win-good/SmartCar_RTOS/README.md

# SmartCar_RTOS
基于 FreeRTOS 搭建传感、决策、电机、蓝牙、视觉、雷达、显示 7 个并行线程任务，消息队列协同调度，实现 10ms 级电机控制与 20ms 级感知决策，配置看门狗与 I2C 总线自救。
