win-good/SmartCar_RTOS/搭建过程总结资料/智能小车项目搭建问题难点与排查思路总结.docx

多模态智能小车

项目搭建过程问题、难点与排查思路总结

硬件平台：STM32F407VGT6 + K230 视觉 + LD2450 毫米波雷达 + FreeRTOS

编制日期：2026 年 9 月 5 日

# 1. 项目概况与系统构成

本项目以 STM32F407VGT6 为主控，构建了一套融合视觉识别、毫米波雷达、超声波测距、惯性导航与气体检测的多模态分级预警小车。系统运行 FreeRTOS 实时操作系统，通过多任务分工实现传感采集、决策融合、电机执行、人机交互与无线通信的并行处理。

## 1.1 硬件构成

类别 | 器件 | 作用
主控 | STM32F407VGT6 | 系统调度与决策核心，运行 FreeRTOS
视觉 | K230（YOLOv11n） | 行人、车辆目标检测，UART 下发识别结果
雷达 | LD2450 毫米波 | 目标距离与方位角检测，独立 UART 解析
测距 | HC-SR04 超声波 ×4 | 前、后、左、右四向障碍探测
姿态 | MPU6050 | 航向角与加速度，用于航向修正
驱动 | TB6612FNG | 双通道电机驱动，PWM 调速与方向控制
执行 | 直流减速电机 ×4 | 两两并联接入 TB6612 两个通道
环境 | MQ-2、MQ-3、DHT11 | 可燃气体、酒精浓度与温湿度检测
交互 | OLED SSD1306 | 状态显示，I2C2 总线
通信 | JDY-31 蓝牙 | 模式切换与遥控指令
避障 | 红外对管 ×2 | 近距循迹与避障辅助

表 1 系统硬件构成

## 1.2 软件任务架构

系统划分为七个 FreeRTOS 任务：传感任务负责超声波轮询与模拟量采集；决策任务完成多源数据融合与三级预警判定；电机任务执行速度与转向控制；蓝牙任务解析遥控指令；K230 任务接收视觉结果；雷达任务解析毫米波帧；显示任务刷新 OLED 界面。各任务通过全局状态结构与队列交互。

多任务架构带来的主要难点在于资源竞争与时序耦合：传感任务的忙等会挤压电机任务的执行窗口，共享状态的并发访问需要保护，这一类问题在后文的排查中反复出现。

# 2. 贯穿全程的排查方法论

本项目累计定位并修复的问题超过二十项，涉及硬件、驱动、协议、逻辑、时序与电源六个层面。在反复试错之后，逐渐沉淀出一套相对稳定的排查思路，它比任何单个问题的具体解法都更有价值。

## 2.1 六条核心原则

1. 分层定位：先确认故障属于硬件层、驱动层、协议层、逻辑层、时序层还是电源层，不同层级的排查手段完全不同，混层排查会浪费大量时间。
2. 版本对照：维护已知可用的历史版本作为基准，用文件差异比对定位回归点。这是本项目效率最高的手段，多次直接锁定问题代码行。
3. 硬件优先怀疑：当软件逻辑经检查确认无误、执行器却无响应时，应优先怀疑供电、接线与器件本身，而不是继续在代码里找原因。
4. 读寄存器取证：直接读取定时器比较寄存器、复位标志寄存器等硬件状态，可以证明软件指令是否真正下发，从而把软件与硬件的责任划清。
5. 最小化改动：确认根因后只改必要部分，避免顺手重构引入新问题；诊断代码用完必须清除，防止污染生产版本。
6. 先查官方协议：外设通信异常时，第一步是核对官方数据手册的帧格式与电气特性，而不是猜测或参考网络上的二手示例代码。

## 2.2 常见误区

- 误区一：把偶发故障当作已解决。接触不良类问题往往在特定状态下暂时消失，未复现不等于已修复。
- 误区二：只看代码不看电气。程序逻辑完全正确但供电不足时，执行器依然不动。
- 误区三：一次改多处。多个修改同时上电，无法判断哪个有效、哪个引入了新问题。
- 误区四：忽略常态负载。加热丝、视觉模块这类持续耗电器件容易被漏算。

# 3. 问题与难点清单

下表汇总了项目搭建过程中遇到的主要问题，按发现与解决的先后顺序排列。后续章节对其中影响较大、排查过程较曲折的问题展开详细说明。

编号 | 问题现象 | 根本原因 | 所属层级 | 状态
01 | OLED 移植后不显示或乱码 | HAL I2C 配置与字库编码不匹配 | 驱动层 | 已解决
02 | 超声波右向与后向无数据 | Echo 引脚 5V 电平导致主控卡死 | 硬件电气 | 已解决
03 | 侧向修正后画大圈不回正 | 时间脉冲式修正被反复触发 | 逻辑层 | 已解决
04 | 蓝牙切换模式后车辆静止 | 供电不足导致电机无法启动 | 电源层 | 已解决
05 | 红外触发后原地打转数秒 | 修正逻辑未设置退出条件 | 逻辑层 | 已解决
06 | 电机嗡鸣但不转动 | 稳压模块负载能力不足 | 电源层 | 已解决
07 | OLED 残留启动横幅字符 | 未在新界面绘制前清屏 | 逻辑层 | 已解决
08 | 雷达数据显示始终为双横线 | 帧同步头识别错误 | 协议层 | 已解决
09 | 静止目标误触发二级预警 | 未按速度字段过滤静止反射体 | 逻辑层 | 已解决
10 | 屏幕周期性闪烁与卡顿 | 自检函数每帧重复初始化屏幕 | 时序层 | 已解决
11 | 系统运行一段时间后冻结 | 栈溢出钩子进入死循环 | RTOS 配置 | 已解决
12 | 电机刷新被延迟 | 传感任务忙等挤压同级任务 | 时序层 | 已解决
13 | MPU6050 断开后车辆不前进 | 航向修正未写入基础速度 | 逻辑层 | 已解决
14 | 转向朝障碍侧偏移 | 无效测距值被当作最大距离 | 逻辑层 | 已解决

表 2 问题清单（高亮为本轮排查中影响最大的两项）

# 4. 重点问题排查过程详解

## 4.1 电机嗡鸣但不转动（电源层）

现象：切换任意模式，四个电机均发出微弱嗡鸣声但不转动；软件检查显示 PWM 与方向信号正常

### 排查思路与过程

1. 第一步，排除逻辑层。检查决策任务的模式判断、电机任务的速度计算，确认目标速度非零、方向引脚电平正确。此路走不通，因为代码逻辑与可用版本一致。
2. 第二步，排除驱动层。用文件差异比对当前 TB6612 驱动与已知可用版本 0.291N，结果完全一致，说明驱动实现没有问题。
3. 第三步，排除时序层。怀疑传感任务忙等挤压电机任务，于是将电机任务优先级临时提升，现象无改善，说明不是调度问题。
4. 第四步，读寄存器取证。在显示任务中增加诊断探针，直接读取 TIM3 的比较寄存器与使能状态，OLED 显示使能为 1、占空比为 50，证明软件确实把正确的 PWM 送到了定时器。同时读取复位标志寄存器，确认单片机没有发生欠压复位。
5. 第五步，转向硬件与电源。既然控制信号已到达定时器，问题只能在功率级。测量发现稳压模块在大电流下输出电压明显跌落，电机端电压不足以建立启动转矩。
6. 第六步，验证与定位。在稳压模块与面包板电源轨之间并联一对杜邦线，接触电阻减半、压降下降，电机随即恢复正常转动，确认根因为供电能力不足叠加大电流接触压降。

### 关键收获

这个问题最有价值的地方在于第四步：读寄存器取证。它用硬件事实证明了软件的责任已尽，从而把排查方向从"继续改代码"果断切换到"检查供电"。如果没有这一步，很可能在逻辑层反复尝试而始终不得其解。详细的功率核算与改进方案见配套文档《智能小车电机供电系统分析》。

## 4.2 蓝牙切换模式后车辆静止（表象层）

现象：蓝牙发送模式切换指令，OLED 上模式号正确变化，但车辆不动

### 排查思路与过程

1. 先确认通信链路。OLED 显示的模式号随指令变化，说明蓝牙接收与指令解析完全正常，问题不在通信层。
2. 再确认决策输出。检查决策任务，模式切换后确实产生了非零的目标速度，说明逻辑层也正常。
3. 最后定位到执行层。电机不转与 4.1 节为同一根因，即供电不足。

### 关键收获

这个案例说明，表面看起来属于某个模块的问题，实际根因可能在完全不同的层级。用户最初报告为"蓝牙模式切换故障"，但蓝牙只是触发条件，真正的故障在电源。排查时要沿着信号流一路追到执行末端，而不是停在第一个看起来异常的环节。

## 4.3 雷达数据始终显示双横线（协议层）

现象：LD2450 已正常供电并接线，OLED 雷达行始终显示占位符，无距离与角度

### 排查思路与过程

1. 确认物理连接。测量雷达供电与 UART 收发线，接线正确、电平匹配。
2. 确认数据到达。用串口工具观察主控接收缓冲区，发现字节流持续到来，说明通信链路通畅，问题出在解析。
3. 核对官方协议。查阅 LD2450 数据手册，发现上报帧的同步头为特定的四字节序列，而原解析代码使用的是另一种三字节头，属于参考了不匹配的示例代码。
4. 重写解析器。按官方协议重新实现帧同步、长度校验、坐标与速度字段解码，解析恢复正常。

### 关键收获

外设通信异常时，核对官方数据手册应当是第一步而非最后一步。网络示例代码常常针对同系列的不同型号或不同固件版本，帧格式存在差异，直接套用会得到一个看似合理却永远匹配不上的解析逻辑。

## 4.4 静止目标误触发二级预警（逻辑层）

现象：车辆静止停放在房间中，雷达持续上报二级预警

### 排查思路与过程

1. 分析数据来源。雷达检测到的确实是真实反射体，如墙壁、家具，数据本身没有错误。
2. 明确业务需求。预警的目的是提示运动目标带来的碰撞风险，静止环境物体不应触发。
3. 查找可用判据。LD2450 的上报帧中除坐标外还包含速度字段，可直接用于区分动静态。
4. 增加过滤逻辑。在雷达任务中对速度低于阈值的目标标记为静止并排除出预警计算，误报消除。

### 关键收获

传感器"数据正确"不等于"符合业务需要"。设计融合逻辑时，要先明确该传感器在本系统中的语义角色，再决定如何使用它的输出。同时应充分利用协议中提供的全部字段，而不是只取最显眼的那一个。

## 4.5 侧向修正后画大圈不回正（逻辑层）

现象：侧向超声波检测到障碍后，车辆持续转弯画大圈，不回到直线行驶

### 排查思路与过程

1. 复现并观察。确认车辆在障碍消失后仍在转弯，说明修正动作没有正确的终止条件。
2. 比对历史版本。与已知行为正常的版本 0.242 做差异比对，发现当前版本采用了时间脉冲式修正，即检测到障碍后启动一个固定时长的转向动作。
3. 分析失效机理。脉冲式修正在障碍持续存在时会被反复触发，每次触发都追加一段转向，累计效果变成持续画圈。
4. 采用瞬时条件式。改回 0.242 版本的思路：仅当一侧距离小于阈值且另一侧明显更宽时才转向，条件不满足立即恢复直线，转向行为与实时传感状态严格绑定。
5. 补充边界处理。无效测距值不再被当作最大距离，避免车辆朝失联的一侧转向；转向生效后立即返回，防止后续直行代码覆盖转向指令。

### 关键收获

避障控制应采用状态跟随式而非时间开环式。时间开环控制一旦触发条件持续存在，就会不断累积动作量，失去自恢复能力。让执行动作与传感状态实时绑定，条件消失动作即刻停止，才能保证系统始终可回到稳态。

## 4.6 超声波某方向无数据导致主控卡死（硬件电气）

现象：右向与后向超声波始终无数据，且系统整体响应异常

### 排查思路与过程

1. 先怀疑软件配置。检查定时器通道、GPIO 复用、中断优先级，确认配置无遗漏。
2. 再怀疑器件。单独测试超声波模块，模块本身工作正常。
3. 定位到电平问题。模块回波输出为 5V 电平，直接接入主控引脚，超出主控引脚的耐压范围，导致引脚被钳位并使相关处理流程卡死。
4. 规避方案。改为 GPIO 轮询方式读取回波，避开受影响的定时器捕获路径，并确认引脚电平处于可接受范围。

### 关键收获

外设不工作时，电气特性检查应与软件配置检查同步进行。模块供电电压与主控 I/O 电压不一致是嵌入式开发中的高频故障源，而且它的表现常常不是"该外设不工作"，而是"整个系统变卡"，容易误导排查方向。

## 4.7 系统运行一段时间后冻结（RTOS 配置）

现象：系统运行数分钟至数十分钟后完全无响应，需断电重启

### 排查思路与过程

1. 启用栈溢出检测。开启 FreeRTOS 的栈溢出检查选项，观察是否触发钩子函数。
2. 发现新问题。钩子函数被触发后系统立即挂死，因为钩子内部实现不当进入了死循环，反而掩盖了原始故障。
3. 扩大栈空间。将各任务栈容量成倍增加，同时相应提高堆总容量以容纳新增的栈空间。
4. 关闭检测钩子。在栈空间调整到位后关闭栈溢出检测，系统恢复长时间稳定运行。

### 关键收获

调试机制本身也可能成为故障源。栈溢出钩子若实现为阻塞或死循环，在真实触发时会让系统彻底失去响应，反而无法获得有效信息。更稳妥的做法是在钩子中仅做最小记录，或直接通过扩大栈空间来消除问题。

## 4.8 屏幕闪烁与显示卡顿（时序层）

现象：OLED 内容周期性闪烁，界面刷新明显卡顿

### 排查思路与过程

1. 定位耗时环节。在显示流程中排查，发现 I2C 自检函数在每一帧都被调用。
2. 分析触发条件。自检读取数据线电平，一旦读到低电平就认为屏幕失联并执行完整重新初始化，而重新初始化耗时上百毫秒。
3. 增加频率限制。将自检与重新初始化的最小间隔限制为两秒，避免每帧重复执行，闪烁与卡顿消除。

### 关键收获

健壮性设计需要考虑执行代价。在高频循环中调用带有长耗时分支的函数，即使该分支很少触发，一旦被触发就会显著影响整个系统的实时性。对这类保护性逻辑设置执行频率上限是必要的。

# 5. 项目主要技术难点归纳

## 5.1 多源异构传感器融合

系统同时接入视觉、毫米波、超声波、惯性与气体五类传感器，它们的更新频率、数据格式、可靠性与失效模式各不相同。视觉约十帧每秒且有漏检，毫米波二十帧每秒但会检出静止环境物体，超声波同步轮询存在忙等且可能失联，惯性传感器可能未连接。

融合策略必须处理三种情况：数据冲突时以哪个为准、某个传感器失效时如何降级、以及各传感器输出的语义边界在哪里。本项目采用分级预警机制，按可信度与响应速度分配各传感器的职责，并对失效情况设计了明确的回退路径。

## 5.2 实时性与资源约束的平衡

四个超声波模块采用同步轮询方式，单次完整测距会占用主控数十毫秒的忙等时间。这段时间内 CPU 无法执行其他任务，直接影响电机控制的刷新率与显示流畅度。

可选方案包括改用定时器输入捕获实现异步测距、错开各模块的触发时刻、或提高电机任务优先级。本项目在不改动硬件接线的前提下，通过调整任务优先级缓解了电机刷新延迟，但这属于权宜之计，彻底解决需要将超声波改为异步采集。

## 5.3 K230 与 STM32 的双主控协同

K230 负责算力密集的视觉推理，STM32 负责实时控制，两者通过串口通信。协同的难点在于：K230 的推理结果有延迟且不保证连续，STM32 不能因为等待视觉数据而阻塞控制循环，同时需要处理 K230 未启动、重启或通信中断等异常场景。

本项目的处理方式是让视觉数据作为决策的增强输入而非必要条件，视觉失联时系统降级为仅依赖雷达与超声波的模式，保证基本功能不中断。

## 5.4 电源完整性

这是本项目耗时最长、也最容易被低估的难点。系统包含视觉模块、气体传感器加热丝与四路电机三类大电流负载，同时又有单片机、传感器等对电压敏感的器件。单一稳压模块供电的方案在电流裕量、瞬态响应与接触电阻三方面都存在不足。

电源问题的隐蔽性在于它不报任何错误，只表现为执行器无力、系统偶发复位或时好时坏。排查这类问题必须借助实测电压与电流，仅凭代码审查无法发现。

## 5.5 面包板原型的可靠性

项目使用面包板与杜邦线搭建，便于快速迭代，但也带来了接触电阻大、簧片额定电流低、振动易松动等问题。多个"时好时坏"的故障最终都指向接触不良。在需要大电流的功率路径上使用面包板属于设计缺陷，后续若制作正式版本，应改为焊接电路板并将功率路径与信号路径分开布线。

# 6. 经验总结与后续建议

## 6.1 有效的工作方法

- 维护已知可用的历史版本。本项目保存了多个阶段性可用版本，在出现回归问题时通过差异比对快速定位改动点，这是效率最高的手段。
- 用硬件事实为软件免责。读取定时器寄存器与复位标志，能够明确判断问题是否在软件侧，避免在错误的方向上持续投入。
- 诊断代码即用即清。临时的探针在定位问题后必须全部移除，否则会残留在生产版本中造成显示混乱与维护负担。
- 区分触发条件与根本原因。多个问题表现为某个模块异常，根因却在其他层级，沿信号流追到末端才能定位。

## 6.2 待改进事项

1. 供电改造：实现电机功率与逻辑电路分路供电，电机直接由电池供电并与逻辑共地。
2. 超声波异步化：改用定时器输入捕获，消除同步轮询的忙等，释放 CPU 时间。
3. 实测替换估算：按供电分析文档中的验证清单完成电流与电压实测，用真实数据替换现有估算值。
4. 硬件固化：将面包板原型改为焊接电路板，功率路径使用足够截面积的走线。
5. 电容配置：在电机驱动芯片的功率端就近增加大容量电解电容与陶瓷电容，吸收启动瞬态冲击。

## 6.3 结语

本项目的问题分布覆盖了嵌入式开发的各个典型层面：从字库编码、引脚电平这类驱动与电气细节，到帧格式解析的协议一致性，再到控制策略的逻辑自洽性、多任务的时序耦合，最后是容易被忽视却影响最大的电源完整性。

回顾整个过程，最大的收获不是解决了多少具体问题，而是形成了一套分层的、以证据为依据的排查习惯：先定位层级，再选择该层级对应的验证手段，用硬件事实而非推测来推进判断，确认后只做最小改动并清除诊断代码。这套方法在后续任何嵌入式项目中都可以直接复用。
