win-good/SmartCar_RTOS/搭建过程总结资料/毕设底层传感器清单.xlsx

序号 | 模块名称 | 型号 | 数量 | 接口类型 | 车载功能定位
1 | 超声波测距模块 | HC-SR04 | 4路（前/左/右/后） | GPIO触发+定时器输入捕获 | 全车近距离障碍物检测，覆盖前后碰撞预警、侧向盲区检测，是车距预警的核心感知源
2 | 六轴姿态传感器 | MPU6050 | 1路 | I2C | 采集三轴加速度+三轴角速度，解算横滚/俯仰角，用于识别急加速、急减速、急转向、车身姿态异常等危险工况
3 | 红外避障模块 | TCRT5000 | 2路（左前/右前） | GPIO数字量输入 | 车头近距盲区补盲，辅助检测低矮障碍物、路沿石，弥补超声波近距检测盲区
4 | 烟雾检测模块 | MQ-2 | 1路 | ADC模拟量 | 检测车内烟雾与可燃气体浓度，实现车内火灾风险预警
5 | 酒精检测模块 | MQ-3 | 1路 | ADC模拟量 | 检测车内酒精浓度，实现酒驾风险提示，丰富行车安全维度
6 | 温湿度模块 | DHT11 | 1路 | 单总线 | 采集车内温湿度数据，完善行车环境感知体系
7 | 分级预警执行单元 | 有源蜂鸣器+三路LED | 1组 | PWM+GPIO | 三级分级声光预警，不同危险等级对应不同蜂鸣频率与三种多个不同颜色LED，LED分布在车身周围.
8 | 电机驱动模块 | TB6612 | 1个 | GPIO+PWM（A口/B口双路） | 驱动左右两侧直流电机，A口接一侧轮子、B口接另一侧轮子，实现车辆前进/后退/转向控制
9 | 蓝牙模块 | JDY-31（兼容HC-05/06） | 1路 | UART串口 | 与手机/上位机无线通信，用于远程查看传感器数据、调试参数及预警状态上报
10 | OLED显示模块 | 0.96寸四引脚OLED | 1个 | I2C | 本地实时显示各传感器数据、危险等级及系统状态，便于现场调试与状态监控
11 | 毫米波雷达模块 | LD2450 | 1路 | UART串口 | 毫米波雷达目标跟踪，检测目标距离、角度与运动速度，用于车辆周边运动目标感知与碰撞预警，与K230视觉数据融合提升目标检测可靠性
