win-good/SmartCar_RTOS/Core/Inc/main.h

#define HCSR04Q_Pin GPIO_PIN_2
#define HCSR04Q_GPIO_Port GPIOE
#define HCSR04Z_Pin GPIO_PIN_3
#define HCSR04Z_GPIO_Port GPIOE
#define HCSR04Y_Pin GPIO_PIN_4
#define HCSR04Y_GPIO_Port GPIOE
#define HCSR04H_Pin GPIO_PIN_5
#define HCSR04H_GPIO_Port GPIOE
#define HW01Z_Pin GPIO_PIN_6
#define HW01Z_GPIO_Port GPIOE
#define HW01Y_Pin GPIO_PIN_7
#define HW01Y_GPIO_Port GPIOE
#define DHT11_DATA_Pin GPIO_PIN_8
#define DHT11_DATA_GPIO_Port GPIOE
#define AIN1_Pin GPIO_PIN_9
#define AIN1_GPIO_Port GPIOE
#define AIN2_Pin GPIO_PIN_10
#define AIN2_GPIO_Port GPIOE
#define BIN1_Pin GPIO_PIN_11
#define BIN1_GPIO_Port GPIOE
#define BIN2_Pin GPIO_PIN_12
#define BIN2_GPIO_Port GPIOE
#define STBY_Pin GPIO_PIN_13
#define STBY_GPIO_Port GPIOE
#define LED2_Pin GPIO_PIN_14
#define LED2_GPIO_Port GPIOE
#define LED3_Pin GPIO_PIN_15
#define LED3_GPIO_Port GPIOE
#define LED1_Pin GPIO_PIN_5
#define LED1_GPIO_Port GPIOB
#define KEY_MODE1_Pin       GPIO_PIN_0
#define KEY_MODE1_GPIO_Port GPIOD
#define KEY_MODE2_Pin       GPIO_PIN_1
#define KEY_MODE2_GPIO_Port GPIOD
#define KEY_MODE3_Pin       GPIO_PIN_2
#define KEY_MODE3_GPIO_Port GPIOD
