win-good/SmartCar_RTOS/Core/Src/gpio.c

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

/* Includes ------------------------------------------------------------------*/
#include "gpio.h"

/*----------------------------------------------------------------------------*/
/* Configure GPIO                                                             */
/*----------------------------------------------------------------------------*/
/** Configure pins as
        * Analog
        * Input
        * Output
        * EVENT_OUT
        * EXTI
*/
void MX_GPIO_Init(void)
{

  GPIO_InitTypeDef GPIO_InitStruct = {0};

  /* GPIO Ports Clock Enable */
  __HAL_RCC_GPIOE_CLK_ENABLE();
  __HAL_RCC_GPIOC_CLK_ENABLE();
  __HAL_RCC_GPIOH_CLK_ENABLE();
  __HAL_RCC_GPIOA_CLK_ENABLE();
  __HAL_RCC_GPIOB_CLK_ENABLE();
  __HAL_RCC_GPIOD_CLK_ENABLE();

  /*Configure GPIO pin Output Level */
  HAL_GPIO_WritePin(GPIOE, HCSR04Q_Pin|HCSR04Z_Pin|HCSR04Y_Pin|HCSR04H_Pin
                          |AIN1_Pin|AIN2_Pin|BIN1_Pin|BIN2_Pin, GPIO_PIN_RESET);

  /*Configure GPIO pin Output Level */
  HAL_GPIO_WritePin(GPIOE, DHT11_DATA_Pin|STBY_Pin|LED2_Pin|LED3_Pin, GPIO_PIN_SET);

  /*Configure GPIO pin Output Level */
  HAL_GPIO_WritePin(LED1_GPIO_Port, LED1_Pin, GPIO_PIN_SET);

  /*Configure GPIO pins : PEPin PEPin PEPin PEPin
                           PEPin */
  GPIO_InitStruct.Pin = HCSR04Q_Pin|HCSR04Z_Pin|HCSR04Y_Pin|HCSR04H_Pin
                          |DHT11_DATA_Pin;
  GPIO_InitStruct.Mode = GPIO_MODE_OUTPUT_PP;
  GPIO_InitStruct.Pull = GPIO_NOPULL;
  GPIO_InitStruct.Speed = GPIO_SPEED_FREQ_HIGH;
  HAL_GPIO_Init(GPIOE, &GPIO_InitStruct);

  /*Configure GPIO pins : PEPin PEPin */
  GPIO_InitStruct.Pin = HW01Z_Pin|HW01Y_Pin;
  GPIO_InitStruct.Mode = GPIO_MODE_INPUT;
  GPIO_InitStruct.Pull = GPIO_NOPULL;
  HAL_GPIO_Init(GPIOE, &GPIO_InitStruct);

  /*Configure GPIO pins : PEPin PEPin PEPin PEPin
                           PEPin PEPin PEPin */
  GPIO_InitStruct.Pin = AIN1_Pin|AIN2_Pin|BIN1_Pin|BIN2_Pin
                          |STBY_Pin|LED2_Pin|LED3_Pin;
  GPIO_InitStruct.Mode = GPIO_MODE_OUTPUT_PP;
  GPIO_InitStruct.Pull = GPIO_NOPULL;
  GPIO_InitStruct.Speed = GPIO_SPEED_FREQ_LOW;
  HAL_GPIO_Init(GPIOE, &GPIO_InitStruct);

  /*Configure GPIO pin : PtPin */
  GPIO_InitStruct.Pin = LED1_Pin;
  GPIO_InitStruct.Mode = GPIO_MODE_OUTPUT_PP;
  GPIO_InitStruct.Pull = GPIO_NOPULL;
  GPIO_InitStruct.Speed = GPIO_SPEED_FREQ_HIGH;
  HAL_GPIO_Init(LED1_GPIO_Port, &GPIO_InitStruct);

  /* USER CODE BEGIN MX_GPIO_Init_Keys */
  /* 2026-08-24 新增：三个模式按键输入（PD0/PD1/PD2，内部上拉，按下=低电平）
   * 按键另一端接 GND；消抖由决策任务的"按下锁定+全松解锁"软件逻辑完成。 */
  GPIO_InitStruct.Pin = KEY_MODE1_Pin | KEY_MODE2_Pin | KEY_MODE3_Pin;
  GPIO_InitStruct.Mode = GPIO_MODE_INPUT;
  GPIO_InitStruct.Pull = GPIO_PULLUP;
  HAL_GPIO_Init(KEY_MODE1_GPIO_Port, &GPIO_InitStruct);
  /* USER CODE END MX_GPIO_Init_Keys */

}
