win-good/SmartCar_RTOS/(commit log)

2026-09-11 v0.242 重构精简：蓝牙下行通道打通
    【相对 v0.241 的实际变更】
    （基于文件哈希比对：21 个文件内容变更，文件集合无增删）
    - App/app_tasks.c：新增 Bt_Send() 蓝牙下行发送函数，
    使小车可向蓝牙上位机回传状态，不再只做单向指令接收
    - App/app_tasks.c：整体重构精简，689 行 → 581 行，
    删除冗余分支，统一决策入口
    - App/app_rtos.c / app_rtos.h：任务创建与句柄管理调整
    - Core/Src/beep.c、gas_sensor.c、infrared.c、OLED.c、
    i2c.c、gpio.c、main.c、freertos.c、stm32f4xx_it.c：驱动层配套修改
    - Core/Inc 多个头文件（beep.h / gas_sensor.h / infrared.h /
    main.h / OLED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
2026-09-11 v0.241 基线版本：多模态感知与三级预警框架成型
    【已实现功能】
    - 感知层：DHT11 温湿度、MQ-2/MQ-3 气体浓度、MPU6050 姿态航向角、
    HC-SR04 四路超声波测距（前/左/右/后）、红外循迹模块
    - 通信层：蓝牙遥控指令接收、K230 视觉模块数据接入
    - 交互层：OLED 实时状态显示
    - 决策层：三级预警框架（ALERT_LEVEL1 / LEVEL2 / LEVEL3）
    - 执行层：TB6612 双路直流电机 PWM 驱动
    - 系统层：FreeRTOS 多任务调度（传感 / 决策 / 电机 / 蓝牙 / K230 / 显示）
    【本版本特征】
    - LD2450 毫米波雷达尚未引入，感知源为超声波 + 红外 + 视觉
    - 侧向纠偏采用时间脉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
2026-09-11 v3.9 当前发布版：修复雷达内存越界、重写 LD2450 协议、供电与调度加固
    【相对 v1.03 的实际变更】
    （基于文件哈希比对：5 个文件内容变更，文件集合无增删）
    - App/app_tasks.c：1038 行 → 1113 行，128 处插入 / 53 处删除
    - App/app_rtos.c (+19/-9)、Core/Inc/FreeRTOSConfig.h (+10/-1)
    - Core/Src/freertos.c (+23)、Core/Src/OLED.c (+11/-1)
    - 源码固件版本号 FW_VERSION_STR "FW V3.5" → "FW V3.9"
    【本版核心改进】
    1. 【严重 BUG】修复雷达环形缓冲区内存越界写
    s_radar_ring 由 [160] 改为 [256]。原数组只有 160 字节，
    但读写索引用 &0xFF 掩码在 256 处回绕，导致索引 160~255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
    [OLED.c, app_rtos.c, app_tasks.c]
2026-09-11 v1.03 (FW V3.5) 雷达预警距离标定 + 修复两处侧向纠偏 BUG
    【相对 v0.301 的实际变更】
    （基于文件哈希比对：仅 2 个文件内容变更，文件集合与函数集合均无增删）
    - App/app_tasks.c：1021 行 → 1038 行，52 处插入 / 35 处删除
    - App/app_rtos.h：4 处插入 / 4 处删除
    - 源码固件版本号 FW_VERSION_STR "FW V3.2" → "FW V3.5"
    1. 修复侧向纠偏"画大圆不回直"——根因是调用点漏写 return（关键 BUG）
    旧代码 ApplySideVeer(s, out) 调用后不返回，后续直行分支会把刚写入的
    偏航速度直接覆盖掉，导致修偏从未真正生效，车辆持续朝障碍物一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
    [app_rtos.h, app_tasks.c]
2026-09-11 v0.301 (FW V3.2) 行为逻辑重构：修复红外原地自转，确立七任务架构
    【相对 v0.291N 的实际变更】
    （基于文件哈希比对：6 个文件内容变更，文件集合无增删）
    - App/app_tasks.c：866 行 → 1021 行（本版起源码首次标注 FW_VERSION_STR "FW V3.2"）
    - App/app_rtos.c (+7/-5)、app_rtos.h (+8/-8)：任务表与句柄声明调整
    - Core/Inc/beep.h (+13/-8)：蜂鸣器告警音效分级接口
    - Core/Inc/tb6612_motor.h (+3/-2)：电机速度档位定义
    - Core/Src/main.c (+1/-1)：主初始化微调
    1. 任务架构：六个任务 → 七个任务
    雷达任务正式纳入任务表，文件头注释同步更新为"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
    [app_rtos.c, app_rtos.h, app_tasks.c, beep.h, main.c, tb6612_motor.h]
2026-09-11 v0.291N 重大升级：引入 LD2450 毫米波雷达，感知源扩展为五模态
    【相对 v0.242 的实际变更】
    （基于文件哈希比对：10 个文件内容变更，文件集合无增删）
    - App/app_tasks.c：新增 7 个核心函数，规模 581 行 → 866 行
    · Radar_ParseTargets()：LD2450 目标帧解析（帧头 AA FF 03 00，
    多目标坐标解码）
    · Radar_RingGet()：雷达数据环形缓冲读取，供决策任务无阻塞取用
    · TaskRadar_Start()：新增独立雷达任务，UART 收帧与解析
    从传感任务中剥离，避免阻塞超声波轮询
    · K230_ParseLine() / K230_RingGet()：K230 视觉协议行解析与
    环形缓冲，视觉数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
2026-09-11 Add files via upload
    项目搭建过程配置与问题总结
    [毕设底层传感器清单.xlsx, 毕设引脚分配表STM32F407VGT6.xlsx, 毕设进度规划-8.19至9.9.xlsx]
